lordvampire/esp32-ahrs-gdl90/case/esp32_case_v2_lid.stl

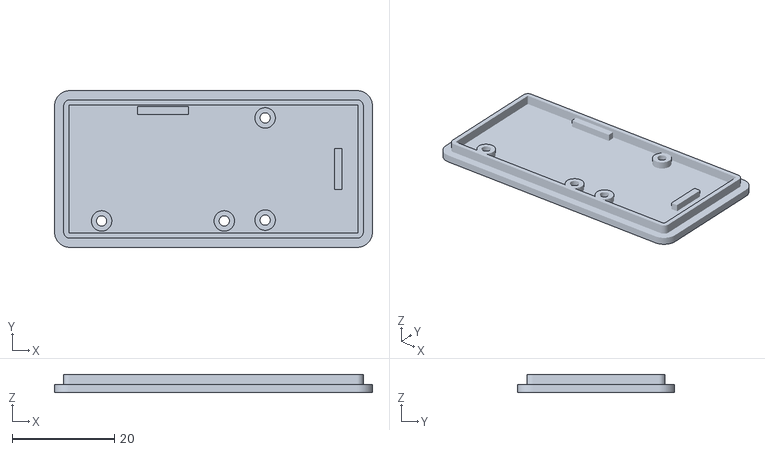
[picture p1: CAD file, 2026-07-20]
case/esp32_case_v2_lid.stl
62.2 x 30.7 x 3.60
