lordvampire/esp32-ahrs-gdl90/case/esp32_case_v2_base.stl

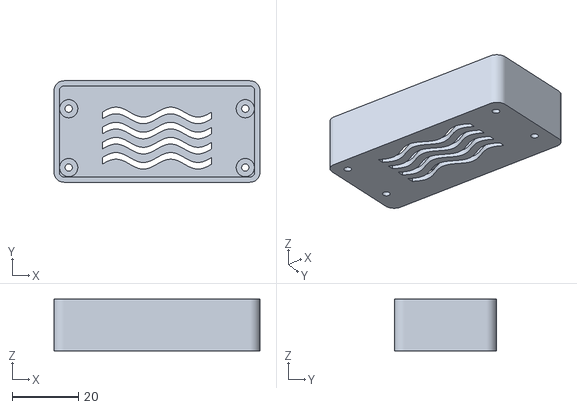
[picture p2: CAD file, 2026-07-20]
case/esp32_case_v2_base.stl
62.2 x 30.7 x 15.6
