lordvampire/esp32-ahrs-gdl90/(commit log)

2026-07-18 v0.1: ESP32 AHRS GDL90 — ForeFlight-compatible attitude reference system
    Open-source AHRS for ESP32-WROOM-32D that broadcasts GDL90 data over WiFi
    to ForeFlight and other EFB apps. Uses BNO086 IMU, BMP390 barometer and
    u-blox GPS.
    - GDL90 binary protocol on UDP port 4000 (Heartbeat, Ownship, GeoAlt)
    - ForeFlight Device ID (0x65/0x00) for automatic device recognition
    - ForeFlight binary AHRS (0x65/0x01) at 5 Hz for smooth synthetic vision
    - ForeFlight text protocol (XGPS/XATT) on UDP port 49002
    - CRC-16 CCITT per FAA GDL90 ICD specification
    - WiFi AP mode with up to 4 simultaneous clients
    - BNO086 watchdog with automatic re-initialisation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
2026-07-18 v0.2: Add Companion Mode — auto-join Stratux WiFi for dual-device operation
    The ESP32 now scans for "stratux"/"Stratux" WiFi at boot. If found, it
    joins the Stratux network as a client (STA mode) and broadcasts AHRS,
    Ownship (BMP390 baro + GPS) and ForeFlight data on the Stratux subnet.
    Stratux provides ADS-B traffic only.
    If no Stratux is found, the device falls back to Standalone Mode with
    its own WiFi AP (unchanged from v0.1).
    - Auto-detect Stratux SSID (case-insensitive scan)
    - WiFi STA mode with auto-reconnect on connection loss
    - Sends all GDL90 messages on Stratux subnet (port 4000 + 49002)
    - Serial debug shows mode indicator and WiFi RSSI in Companion Mode
    - Updated README with d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
2026-07-18 Fix inverted roll axis for correct bank indication
    Negate roll output in quaternion-to-Euler conversion to match aviation
    convention (positive = right wing down) for the BNO086 mounting
    orientation on the board.
    Test findings documented:
    - Companion Mode: Stratux found and connected successfully
    - ForeFlight AHRS works when Stratux GPS/AHRS/Baro are disabled
    - Known issue: enabling Stratux GPS causes AHRS to behave erratically
    in ForeFlight (conflicting Ownship Reports)
    - Known issue: BMP390 baro not reaching ForeFlight in Companion Mode
    - Known issue: ForeFlight device name flickers between Stratux and
    AHRS-GDL names (both devices send FF-ID 0x65/0x00)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
    [bno086.cpp]
2026-07-18 Add CLAUDE.md with project notes for v0.3 and v0.4
    Documents known Companion Mode issues and planned work:
    - v0.3: Web configuration interface (ESP32 WebServer + NVS)
    - v0.4: Stratux BNO086 integration (Go driver already exists
    in lordvampire/stratux fork, needs review and testing)
    References existing BNO086 Go I2C-SHTP driver (~430 lines) and
    WebUI comparison pages already committed to the Stratux fork.
2026-07-18 v0.3: Add web configuration interface
    Add browser-based settings page (http://192.168.10.1) for runtime
    configuration without reflashing. Resolves Companion Mode conflicts
    (duplicate Ownship Reports, device name flicker) by allowing pilots
    to toggle individual GDL90 messages on/off.
    New files:
    - config.h: Config struct with NVS load/save (Preferences library)
    - webui.h: Dark-theme single-page UI with live status + settings form
    Changes:
    - esp32-ahrs-gdl90.ino: WebServer on port 80, REST API endpoints
    (GET/POST /api/settings, GET /api/status, POST /api/reboot),
    config-driven mode selection (Auto/Force-Standalone/Force-Companion),
    message toggle guards, configurable WiFi SSID/password/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
    [bno086.cpp, bno086.h, config.h, esp32-ahrs-gdl90.ino]
2026-07-18 v0.4: Add per-sensor enable/disable config (BNO086, BMP390, GPS)
    Sensors can now be individually enabled/disabled via WebUI and are
    persisted in NVS. Disabled or failed sensors no longer block boot —
    the system continues gracefully with available hardware.
    [config.h, esp32-ahrs-gdl90.ino]
2026-07-19 Update CLAUDE.md for v0.4 release
    Document per-sensor enable/disable feature, mark v0.3 as completed,
    renumber Stratux BNO086 integration to v0.5.
2026-07-20 Case v2: Add BNO086 + BMP390 lid mounting, increase inner height to 14mm
    - inner_h 10→14mm for stacked sensor boards
    - BNO086 screw bosses (2× M2, 24mm spacing) on lid
    - BMP390 screw bosses (2× M2, 20mm spacing) on lid, 8mm from BNO holes
    - Anti-rotation supports for both sensor boards
    - USB-C cutout closed at top (7mm opening height)
    - Vent slots shortened by 10mm per side to clear bosses
    - Removed: PCB ledge, corner feet, USB-C cable extension
    [esp32_case_v2.scad]
2026-07-20 Add STL exports and command-line part selector
    - Render selection via -D 'part="base|lid|assembled|both"'
    - Export base and lid as separate STL files for Bambu Studio
    [esp32_case_v2.scad, esp32_case_v2_base.stl, esp32_case_v2_lid.stl]
2026-07-20 Update CLAUDE.md with Case v2 documentation
2026-07-20 Add v0.5 plan: BNO086 calibration & sensor fusion optimization
    Covers DCD persistence, WebUI calibration procedure, dynamic cal
    control, accuracy monitoring, and Game Rotation Vector switch.
2026-07-20 v0.5: ESP32-S3 migration, BNO086 calibration & sensor fusion
    Migrate from ESP32-WROOM-32D to SparkFun Thing Plus ESP32-S3 (I2C SDA/SCL
    to GPIO 8/9). Add BNO086 calibration system with DCD persistence, accuracy
    monitoring, guided WebUI calibration procedure, and configurable sensor
    fusion mode (ARVR Stabilized Game RV default, immune to cockpit magnetic
    interference). Report rate increased from 10Hz to 50Hz.
    [bno086.cpp, bno086.h, config.h, esp32-ahrs-gdl90.ino]
2026-07-23 Fix BNO086 crash, WebUI save corruption, and BMP390 address
    - Fix BNO086 NULL pointer crash: consume wasReset() flag after begin()
    and reinit() to prevent update() from triggering SHTP callbacks
    before _sensor_value is initialized by first getSensorEvent()
    - Reorder setup(): WiFi scan/AP first, sensor init last — avoids
    SHTP protocol corruption during multi-second WiFi operations
    (BNO086 datasheet §1.2.2: no I2C polling, §1.2.4.1: 10ms timeout)
    - Fix WebUI settings save corruption: save to NVS only without
    modifying live config (changes apply after reboot, not immediately)
    - Fix JSON parser: jsonBool() now uses quoted key matching to prevent
    false matches inside string values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
    [bmp390.h, bno086.cpp, bno086.h, esp32-ahrs-gdl90.ino]
2026-07-23 Update README for ESP32-S3, Web UI, calibration and current state
    Rewrite hardware section for SparkFun Thing Plus ESP32-S3 (GPIO 8/9,
    BNO086 at 0x4B, BMP390 at 0x76). Document the Web Configuration UI
    with live status, BNO086 calibration procedure, REST API endpoints,
    per-sensor/per-message toggles, and NVS-based settings persistence.
    Add sensor fusion mode comparison, 3D printed case section, and
    updated build instructions for esptool v5.x two-step process.
